Misha999777/triangle/docs/software/architecture.md

# Software Architecture

The software is structured into modular components designed for the RP2350 dual-core architecture.

## Dual-Core Processing

*   **Core 0**: Handles the main stabilization control loop (`u = k1*angle + k2*gyro + k3*motor_speed`), IMU reading via `AngleSensor`, and BLE communication via `Communication`.
*   **Core 1**: Dedicated entirely to the high-frequency motor control loop. It reads the absolute angle from the `MotorSensor` and implements the Field Oriented Control (FOC) algorithms in `Motor` and drives the PWM via `Driver`.

## Directory Structure

*   **`src/main.cpp`**: The entry point. Initializes hardware, launches the motor loop on Core 1, and runs the main control loop on Core 0.
*   **`src/hardware/`**:
    *   `AngleSensor`: Handles MPU6050 communication, data fusion (Complementary filter), and calibration.
    *   `Motor`: Implements the FOC algorithm, controlling the 3-phase voltage to generate torque.
    *   `MotorSensor`: Reads absolute angle from the SPI magnetic encoder.
    *   `Driver`: Generates 3-phase PWM signals.
*   **`src/controller/`**:
    *   `Controller`: Implements the state-feedback controller logic to calculate torque and adjust `targetAngle`.
    *   `Storage`: Saves/Restores calibration data and tuning parameters to flash memory.
*   **`src/bluetooth/`**:
    *   `Communication`: Manages the BLE stack, GATT services, and handles incoming parameter updates.
