Misha999777/triangle/(list of files, cad)

Other CAD files:
models/Clip.f3d
models/Motor mount.f3d
